BarOs0/Power-consumption-driver/PCB_project/LIB_TSC1801BILT/TSC1801BILT/3D/TSC1801BILT.stp

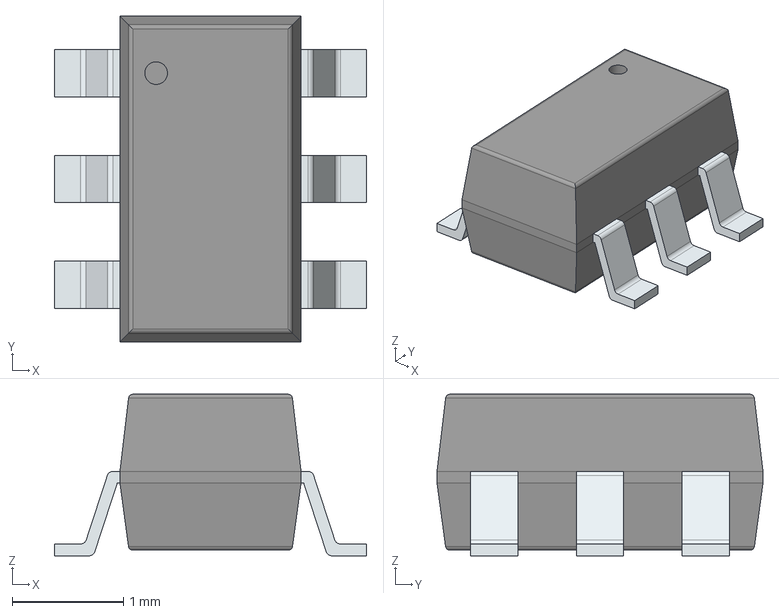
[picture p40: CAD file, 2026-01-12]
PCB_project/LIB_TSC1801BILT/TSC1801BILT/3D/TSC1801BILT.stp
2.80 x 2.92 x 1.45 mm
PinsArrayLR
