BarOs0/Power-consumption-driver/PCB_project/LIB_BQ25173DSGR/BQ25173DSGR/3D/BQ25173DSGR.stp

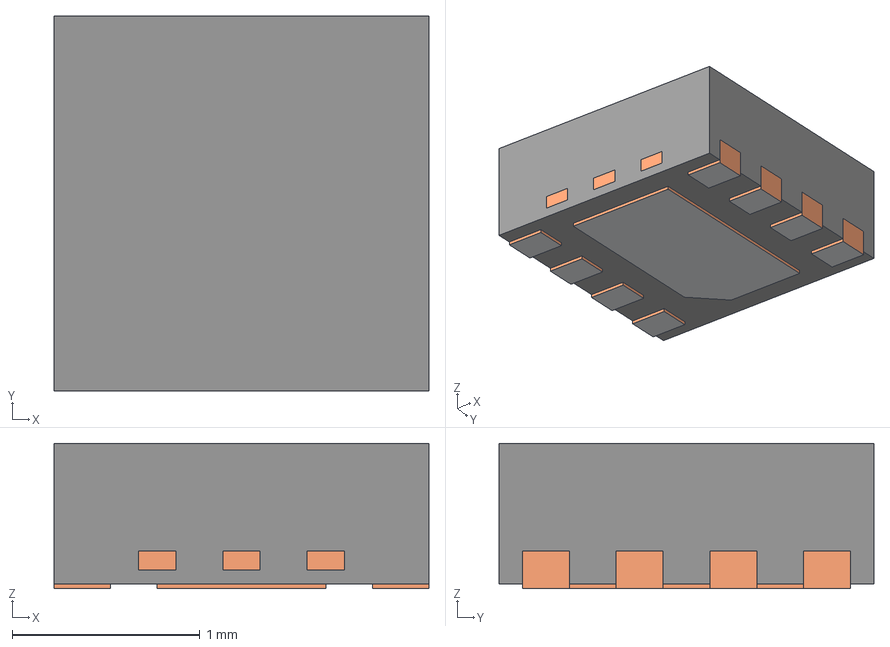
[picture p41: CAD file, 2026-01-12]
PCB_project/LIB_BQ25173DSGR/BQ25173DSGR/3D/BQ25173DSGR.stp
2.00 x 2.00 x 0.775 mm
BODY-SON
FRAME-DSG0008A
PIN1-ID
