BarOs0/Power-consumption-driver/PCB_project/power_consumption_driver.kicad_pcb

## KiCad design PCB_project/power_consumption_driver.kicad_pcb (2026-01-12)

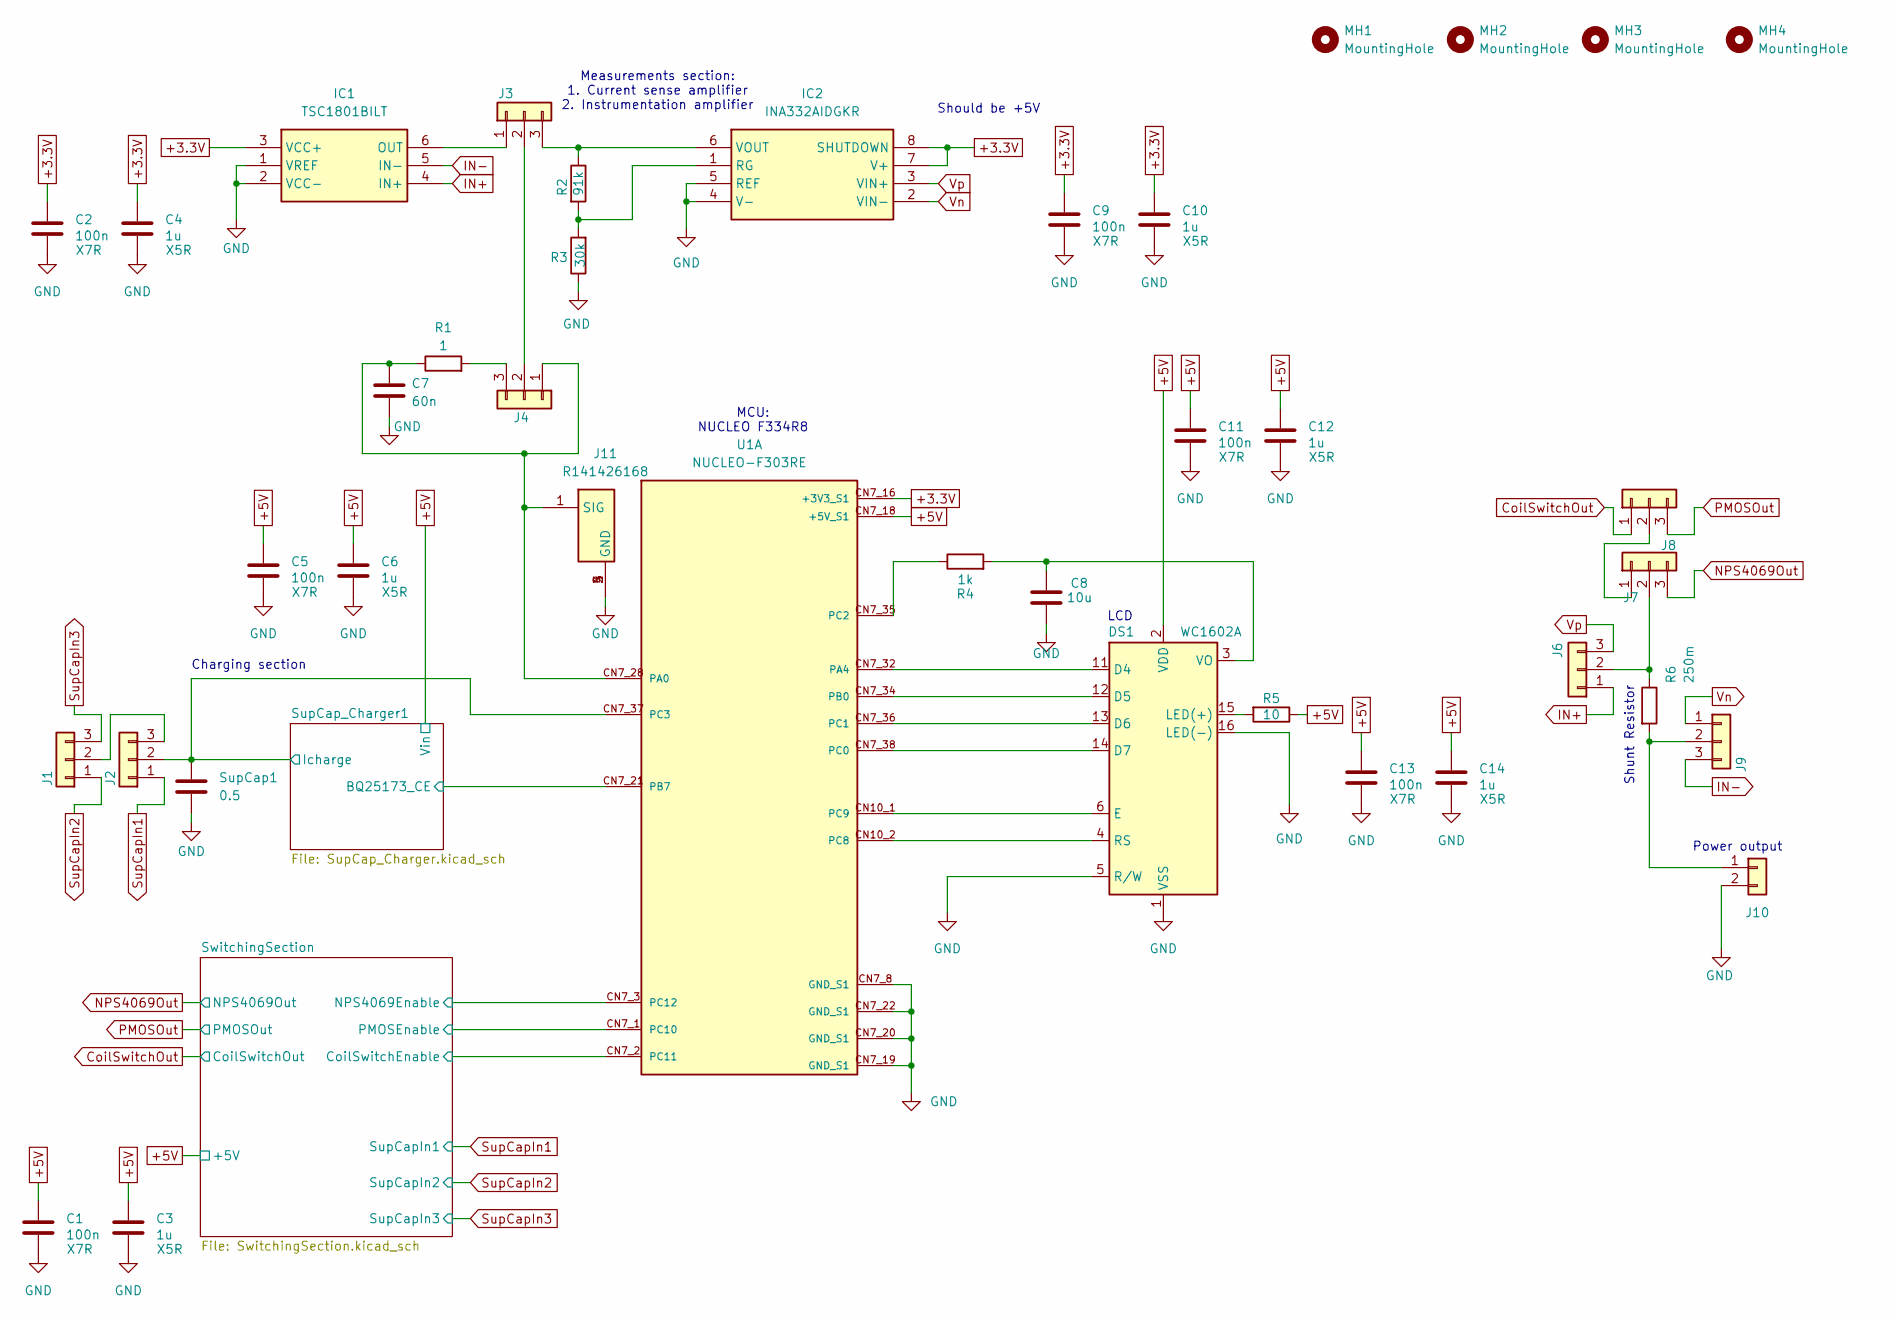
[picture p42: schematic power_consumption_driver.kicad_sch, Power consumption driver]

Parts:
C1, C2, C5, C9, C11, C13: 100n; C_0402_1005Metric_Pad0.74x0.62mm_HandSolder
C3, C4, C6, C10, C12, C14: 1u; C_0402_1005Metric_Pad0.74x0.62mm_HandSolder
C7: 60n; C_0402_1005Metric_Pad0.74x0.62mm_HandSolder
C8: 10u; C_0402_1005Metric_Pad0.74x0.62mm_HandSolder
DS1: WC1602A
IC1: TSC1801BILT; SOT95P280X145-6N; Manufacturer_Part_Number TSC1801BILT
IC2: INA332AIDGKR; SOP65P490X110-8N; Manufacturer_Part_Number INA332AIDGKR; Mouser Part Number 595-INA332AIDGKR
J1, J2, J3, J4, J6, J7, J8, J9: Conn_01x03; PinHeader_1x03_P2.54mm_Vertical
J10: Conn_01x02; PinHeader_1x02_P2.54mm_Vertical
J11: R141426168; Manufacturer_Part_Number R141426168; Mouser Part Number 501-R141426168
MH1, MH2, MH3, MH4: MountingHole; MountingHole_3.2mm_M3_ISO14580_Pad
R1: 1; R_0805_2012Metric_Pad1.20x1.40mm_HandSolder
R2: 91k; R_0805_2012Metric_Pad1.20x1.40mm_HandSolder
R3: 30k; R_0805_2012Metric_Pad1.20x1.40mm_HandSolder
R4: 1k; R_0805_2012Metric_Pad1.20x1.40mm_HandSolder
R5: 10; R_0805_2012Metric_Pad1.20x1.40mm_HandSolder
R6: 250m; R_0805_2012Metric_Pad1.20x1.40mm_HandSolder
SupCap1: 0.5; C_Radial_D8.0mm_H11.5mm_P3.50mm
U1: NUCLEO-F303RE; ST_NUCLEO-F303RE; PARTREV 14

Connections:
+3.3V: C2.1, C4.1, C9.1, C10.1, IC1.3 (VCC+), IC2.7 (V+), IC2.8 (SHUTDOWN), U1.CN7_16 (+3V3_S1)
+5V: C1.1, C3.1, C5.1, C6.1, C11.1, C12.1, C13.1, C14.1, DS1.2 (VDD), R5.1, U1.CN7_18 (+5V_S1); also elsewhere on the board
/SupCap_Charger1/BQ25173_CE: U1.CN7_21 (PB7); also elsewhere on the board
/SupCap_Charger1/Icharge: J2.2, SupCap1.1, U1.CN7_37 (PC3); also elsewhere on the board
/SwitchingSection/CoilSwitchEnable: U1.CN7_2 (PC11); also elsewhere on the board
/SwitchingSection/NPS4069Enable: U1.CN7_3 (PC12); also elsewhere on the board
/SwitchingSection/PMOSEnable: U1.CN7_1 (PC10); also elsewhere on the board
CoilSwitchOut: J7.1; also elsewhere on the board
GND: C1.2, C2.2, C3.2, C4.2, C5.2, C6.2, C7.2, C8.2, C9.2, C10.2, C11.2, C12.2, C13.2, C14.2, DS1.1 (VSS), DS1.5 (R/W), DS1.16 (LED(-)), IC1.1 (VREF), IC1.2 (VCC-), IC2.4 (V-), IC2.5 (REF), J10.2, J11.2 (GND), J11.3 (GND), J11.4 (GND), J11.5 (GND), R3.1, SupCap1.2, U1.CN7_8 (GND_S1), U1.CN7_19 (GND_S1), U1.CN7_20 (GND_S1), U1.CN7_22 (GND_S1); also elsewhere on the board
IN+: IC1.4 (IN+), J6.1
IN-: IC1.5 (IN-), J9.3
NPS4069Out: J8.3; also elsewhere on the board
unnamed: DS1.11 (D4), U1.CN7_32 (PA4)
unnamed: DS1.12 (D5), U1.CN7_34 (PB0)
unnamed: DS1.13 (D6), U1.CN7_36 (PC1)
unnamed: DS1.14 (D7), U1.CN7_38 (PC0)
unnamed: DS1.6 (E), U1.CN10_1 (PC9)
unnamed: DS1.15 (LED(+)), R5.2
unnamed: DS1.4 (RS), U1.CN10_2 (PC8)
unnamed: C8.1, DS1.3 (VO), R4.2
unnamed: IC1.6 (OUT), J3.1
unnamed: IC2.1 (RG), R2.2, R3.2
unnamed: IC2.6 (VOUT), J3.3, R2.1
unnamed: J1.2, J2.3
unnamed: J3.2, J4.2
unnamed: J4.3, R1.2
unnamed: J6.2, J8.2, R6.1
unnamed: J7.2, J8.1
unnamed: J9.2, J10.1, R6.2
unnamed: C7.1, J4.1, J11.1 (SIG), R1.1, U1.CN7_28 (PA0)
unnamed: R4.1, U1.CN7_35 (PC2)
PMOSOut: J7.3; also elsewhere on the board
SupCapIn1: J2.1; also elsewhere on the board
SupCapIn2: J1.1; also elsewhere on the board
SupCapIn3: J1.3; also elsewhere on the board
Vn: IC2.2 (VIN-), J9.1
Vp: IC2.3 (VIN+), J6.3

Notes on the sheet:
Should be +5V
Shunt Resistor
Measurements section: 1. Current sense amplifier 2. Instrumentation amplifier
MCU: NUCLEO F334R8
Charging section
Power output
LCD

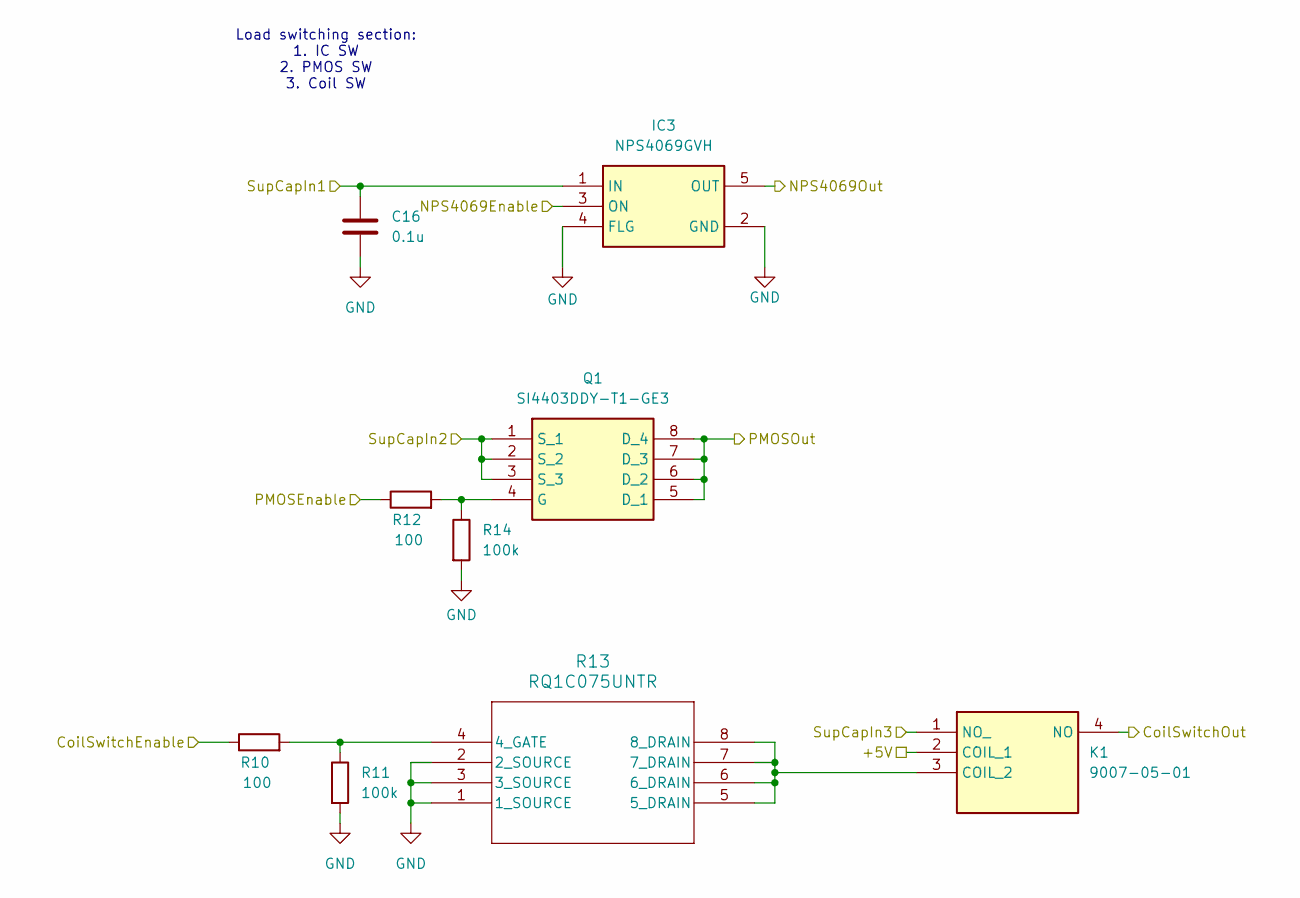
[picture p43: schematic SwitchingSection.kicad_sch, Power consumption driver]

Parts:
C16: 0.1u; C_0402_1005Metric_Pad0.74x0.62mm_HandSolder
IC3: NPS4069GVH; SOT95P275X110-5N; Manufacturer_Part_Number NPS4069GVH
K1: 9007-05-01; 90070501; Manufacturer_Part_Number 9007-05-01; Mouser Part Number 816-9007-05-01
Q1: SI4403DDY-T1-GE3; SOIC127P600X175-8N; Manufacturer_Part_Number SI4403DDY-T1-GE3; Mouser Part Number 78-SI4403DDY-T1-GE3
R10, R12: 100; R_0805_2012Metric_Pad1.20x1.40mm_HandSolder
R11, R14: 100k; R_0805_2012Metric_Pad1.20x1.40mm_HandSolder
R13: RQ1C075UNTR; TRANS_RQ1A070Z_ROM

Connections:
+5V: K1.2 (COIL_1); also elsewhere on the board
/SwitchingSection/CoilSwitchEnable: R10.1; also elsewhere on the board
/SwitchingSection/NPS4069Enable: IC3.3 (ON); also elsewhere on the board
/SwitchingSection/PMOSEnable: R12.1; also elsewhere on the board
CoilSwitchOut: K1.4 (NO); also elsewhere on the board
GND: C16.2, IC3.2 (GND), IC3.4 (FLG), R11.2, R13.1 (1_SOURCE), R13.2 (2_SOURCE), R13.3 (3_SOURCE), R14.2; also elsewhere on the board
NPS4069Out: IC3.5 (OUT); also elsewhere on the board
unnamed: K1.3 (COIL_2), R13.5 (5_DRAIN), R13.6 (6_DRAIN), R13.7 (7_DRAIN), R13.8 (8_DRAIN)
unnamed: Q1.4 (G), R12.2, R14.1
unnamed: R10.2, R11.1, R13.4 (4_GATE)
PMOSOut: Q1.5 (D_1), Q1.6 (D_2), Q1.7 (D_3), Q1.8 (D_4); also elsewhere on the board
SupCapIn1: C16.1, IC3.1 (IN); also elsewhere on the board
SupCapIn2: Q1.1 (S_1), Q1.2 (S_2), Q1.3 (S_3); also elsewhere on the board
SupCapIn3: K1.1 (NO_); also elsewhere on the board

Notes on the sheet:
Load switching section: 1. IC SW 2. PMOS SW 3. Coil SW

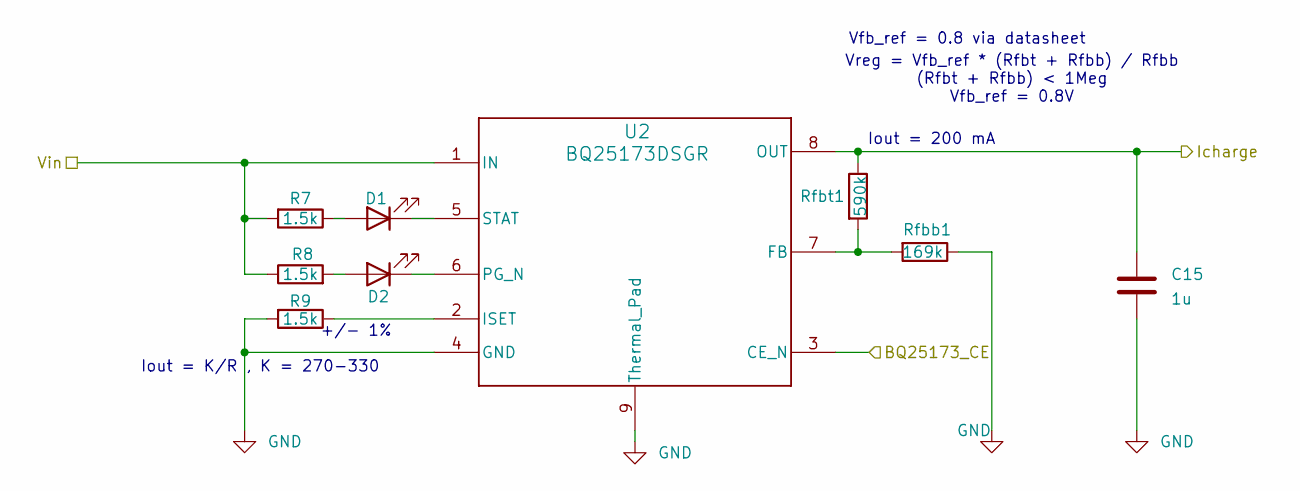
[picture p44: schematic SupCap_Charger.kicad_sch, Power consumption driver]

Parts:
C15: 1u; C_0402_1005Metric_Pad0.74x0.62mm_HandSolder
D1, D2: LED; LED_D3.0mm_Clear
R7, R8, R9: 1.5k; R_0805_2012Metric_Pad1.20x1.40mm_HandSolder
Rfbb1: 169k; R_0805_2012Metric_Pad1.20x1.40mm_HandSolder
Rfbt1: 590k; R_0805_2012Metric_Pad1.20x1.40mm_HandSolder
U2: BQ25173DSGR; SON50P200X200X80-9N

Connections:
+5V: R7.2, R8.1, U2.1 (IN); also elsewhere on the board
/SupCap_Charger1/BQ25173_CE: U2.3 (CE_N); also elsewhere on the board
/SupCap_Charger1/Icharge: C15.2, Rfbt1.1, U2.8 (OUT); also elsewhere on the board
GND: C15.1, R9.2, Rfbb1.1, U2.4 (GND), U2.9 (Thermal_Pad); also elsewhere on the board
unnamed: D1.2 (A), R7.1
unnamed: D1.1 (K), U2.5 (STAT)
unnamed: D2.2 (A), R8.2
unnamed: D2.1 (K), U2.6 (PG_N)
unnamed: Rfbb1.2, Rfbt1.2, U2.7 (FB)
unnamed: R9.1, U2.2 (ISET)

Notes on the sheet:
Iout = 200 mA
Vfb_ref = 0.8 via datasheet
Iout = K/R , K = 270-330
Vreg = Vfb_ref * (Rfbt + Rfbb) / Rfbb (Rfbt + Rfbb) < 1Meg Vfb_ref = 0.8V
+/- 1%

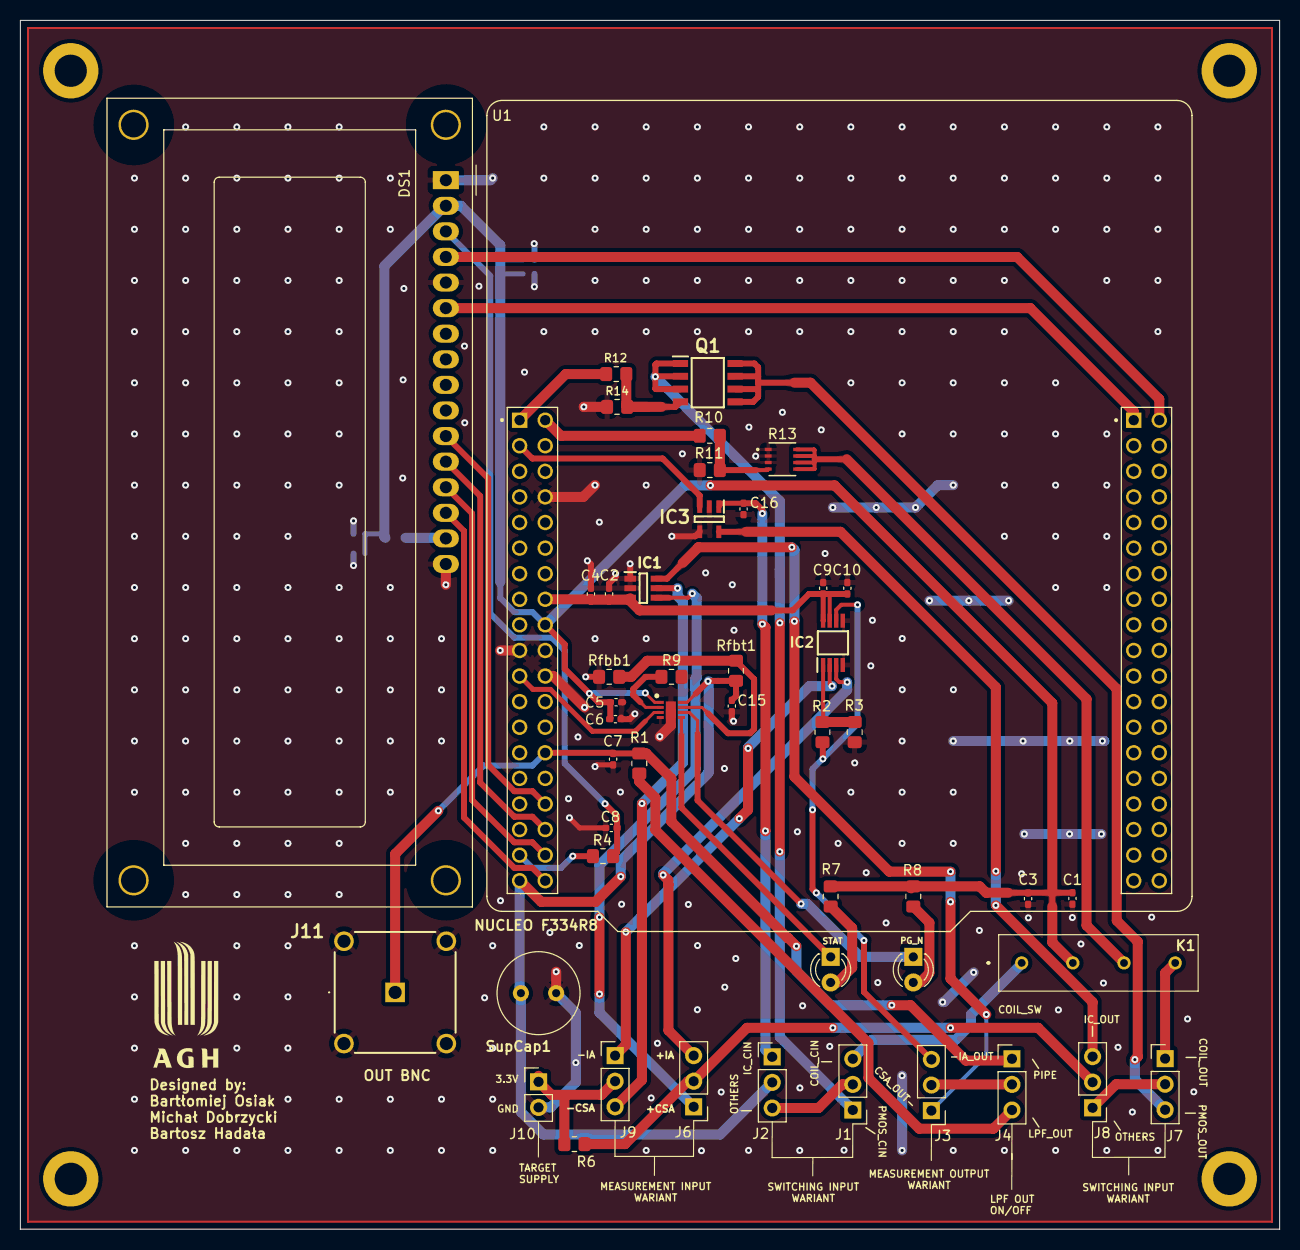
[picture p45: board power_consumption_driver.kicad_pcb from above]

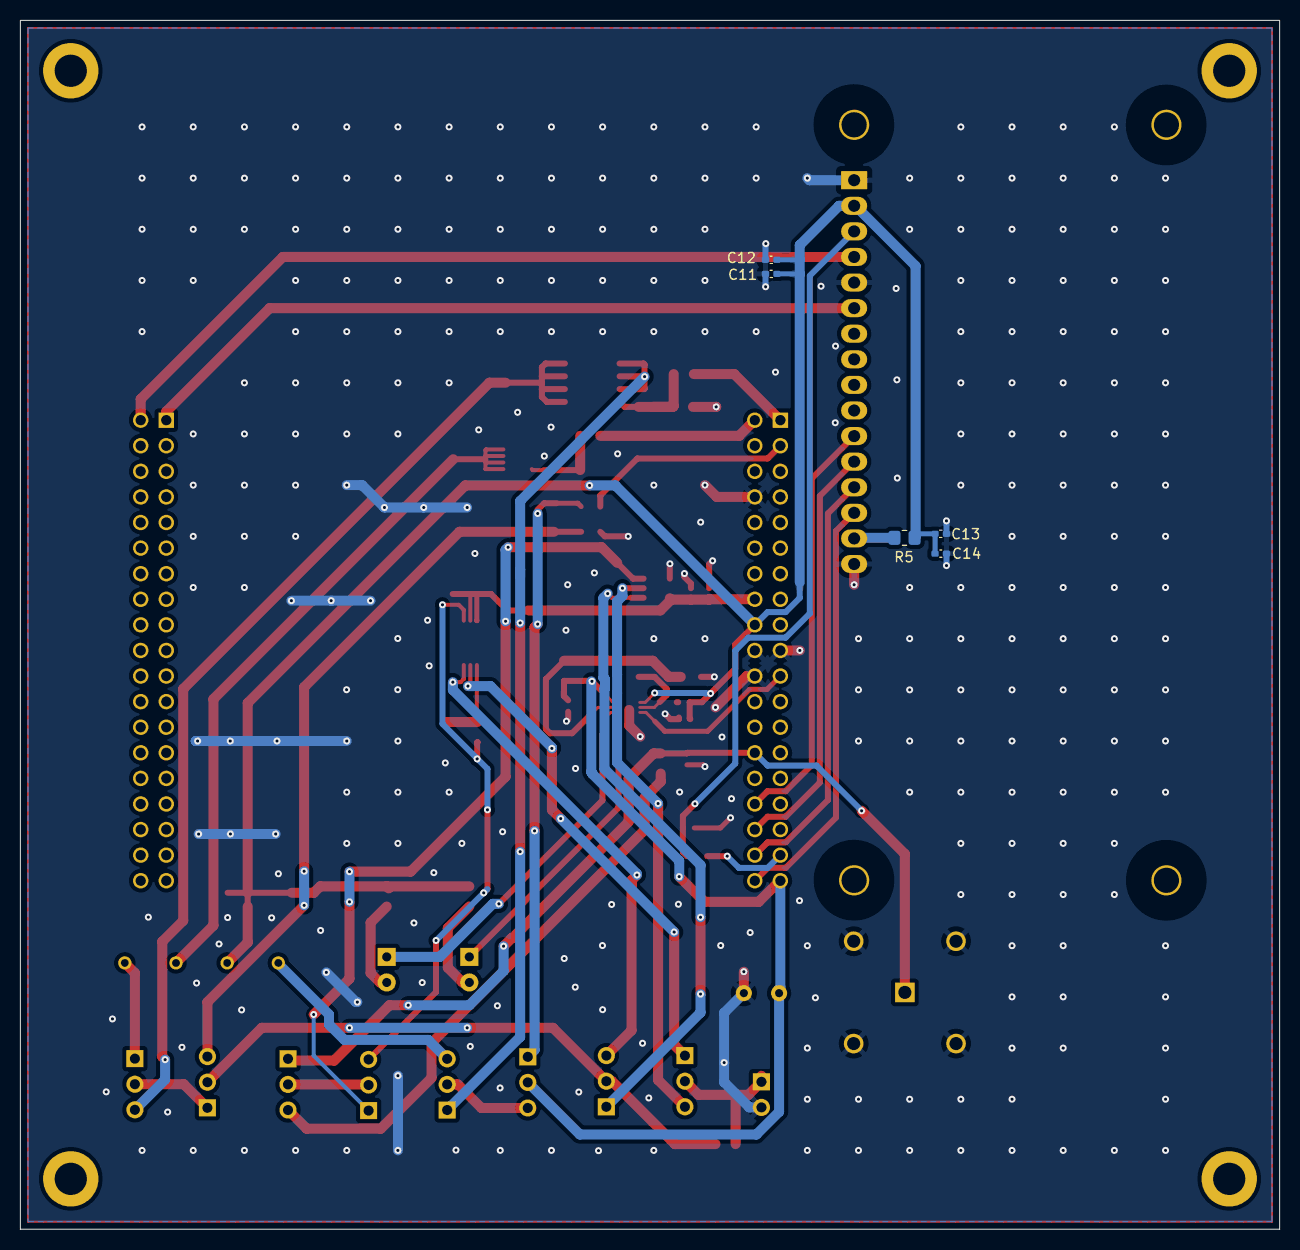
[picture p46: board power_consumption_driver.kicad_pcb from below]

Board: 2 copper layers, 125.0 x 120.0 mm, 57 parts (5 on the bottom side), 46 nets.
