BarOs0/Power-consumption-driver/STM_project/DesignLabPoprawkav8/DesignLabPoprawkav5/DesignLabPoprawkav1/DesignLab/Core/Inc/main.h

#define B1_Pin GPIO_PIN_13
#define B1_GPIO_Port GPIOC
#define RCC_OSC32_OUT_Pin GPIO_PIN_15
#define RCC_OSC32_OUT_GPIO_Port GPIOC
#define D7_Pin GPIO_PIN_0
#define D7_GPIO_Port GPIOC
#define D6_Pin GPIO_PIN_1
#define D6_GPIO_Port GPIOC
#define PWM_LCD_Pin GPIO_PIN_2
#define PWM_LCD_GPIO_Port GPIOC
#define ADC2_CAP_Pin GPIO_PIN_3
#define ADC2_CAP_GPIO_Port GPIOC
#define ADC1_RES_Pin GPIO_PIN_0
#define ADC1_RES_GPIO_Port GPIOA
#define USART_TX_Pin GPIO_PIN_2
#define USART_TX_GPIO_Port GPIOA
#define USART_RX_Pin GPIO_PIN_3
#define USART_RX_GPIO_Port GPIOA
#define D4_Pin GPIO_PIN_4
#define D4_GPIO_Port GPIOA
#define D5_Pin GPIO_PIN_0
#define D5_GPIO_Port GPIOB
#define RS_Pin GPIO_PIN_8
#define RS_GPIO_Port GPIOC
#define E_Pin GPIO_PIN_9
#define E_GPIO_Port GPIOC
#define TMS_Pin GPIO_PIN_13
#define TMS_GPIO_Port GPIOA
#define TCK_Pin GPIO_PIN_14
#define TCK_GPIO_Port GPIOA
#define PMOS_NENABLE_Pin GPIO_PIN_10
#define PMOS_NENABLE_GPIO_Port GPIOC
#define COIL_ENABLE_Pin GPIO_PIN_11
#define COIL_ENABLE_GPIO_Port GPIOC
#define IC_ENABLE_Pin GPIO_PIN_12
#define IC_ENABLE_GPIO_Port GPIOC
#define SWO_Pin GPIO_PIN_3
#define SWO_GPIO_Port GPIOB
#define BQ25173_CE_Pin GPIO_PIN_7
#define BQ25173_CE_GPIO_Port GPIOB
